Roberto-Barnhardt/CafeteraIOT/Memoria/Figures/hc-sr04.jpg

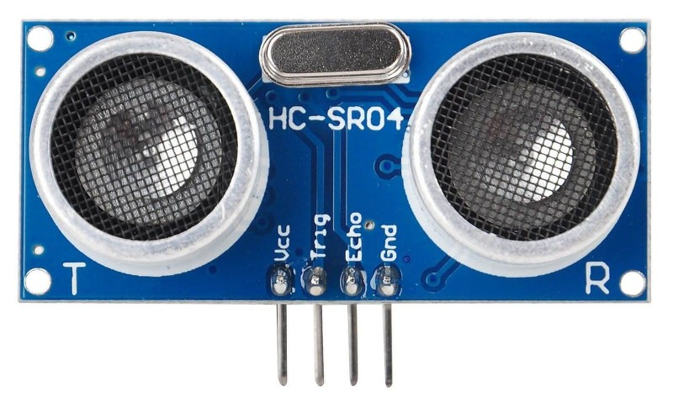
Memoria/Figures/hc-sr04.jpg
