Roberto-Barnhardt/CafeteraIOT/Memoria/Figures/microsw_cerrado.jpg

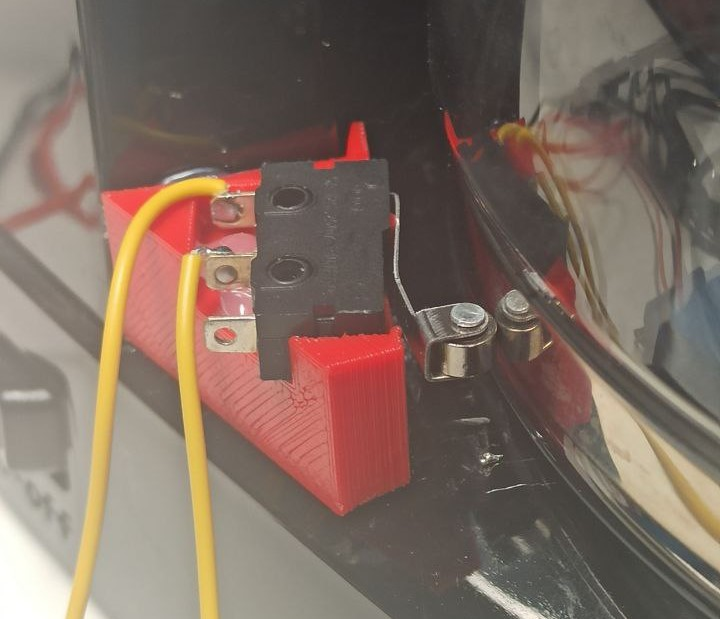
Memoria/Figures/microsw_cerrado.jpg
