Roberto-Barnhardt/CafeteraIOT/README.md

# Cafetera IOT

En este proyecto se van a integrar funcionalidades IOT en una cafetera convencional de filtro.
Diagrama
