Roberto-Barnhardt/CafeteraIOT/Art/Portada.png

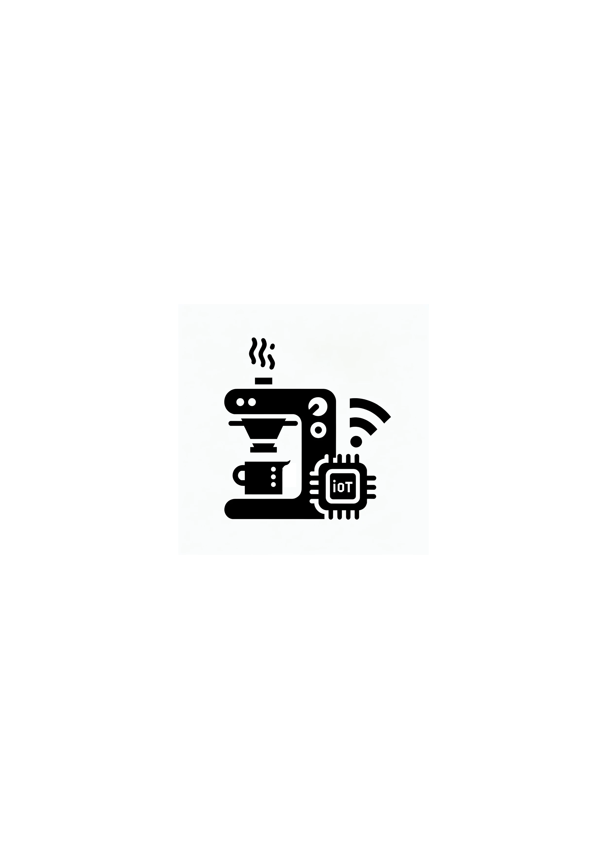
Art/Portada.png
