Roberto-Barnhardt/CafeteraIOT/CAD/GrabCAD/Exploded.png

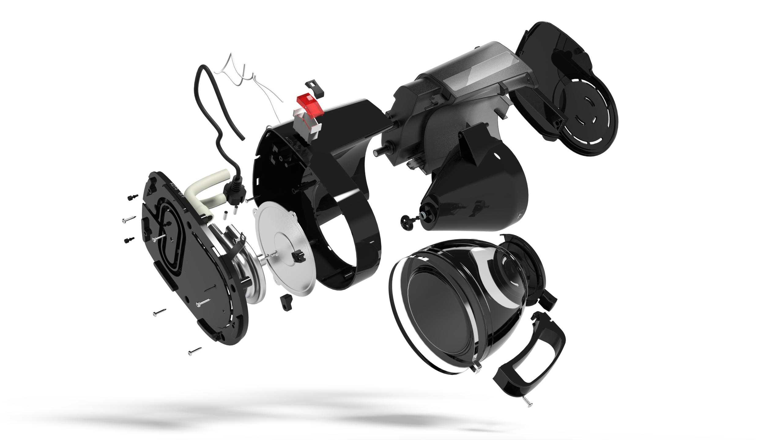
CAD/GrabCAD/Exploded.png
