Roberto-Barnhardt/CafeteraIOT/CAD/GrabCAD/Iso_1.png

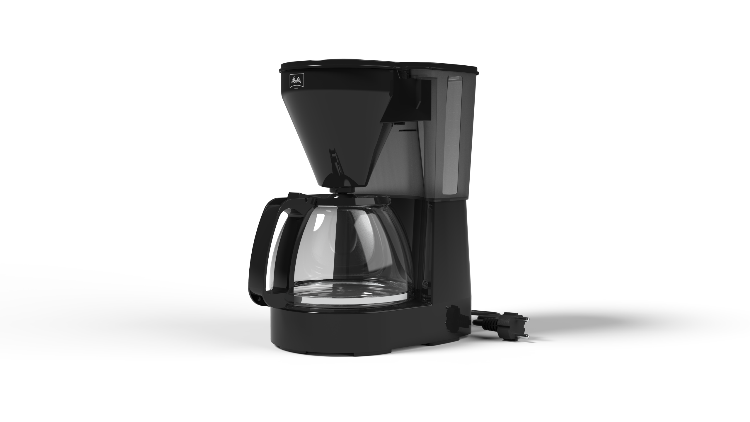
CAD/GrabCAD/Iso_1.png
