Roberto-Barnhardt/CafeteraIOT/CAD/GrabCAD/Iso_2.png

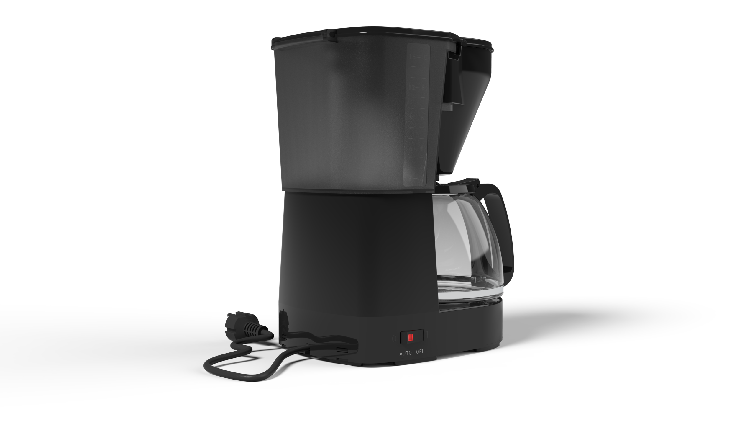
CAD/GrabCAD/Iso_2.png
