Roberto-Barnhardt/CafeteraIOT/CAD/GrabCAD/Iso_3.png

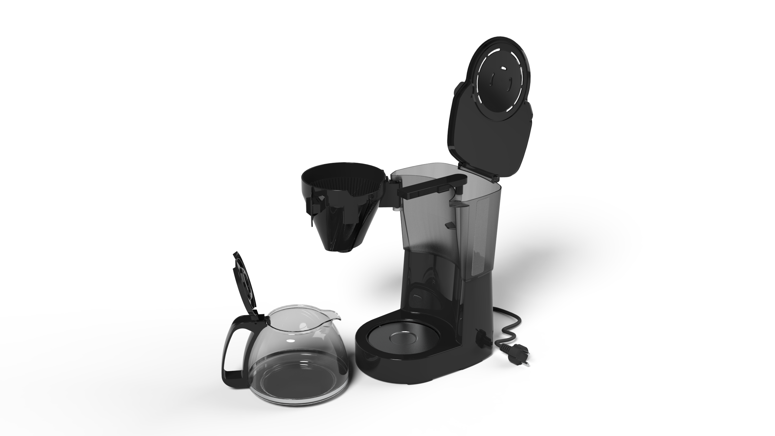
CAD/GrabCAD/Iso_3.png
