Roberto-Barnhardt/CafeteraIOT/CAD/GrabCAD/Iso_4.png

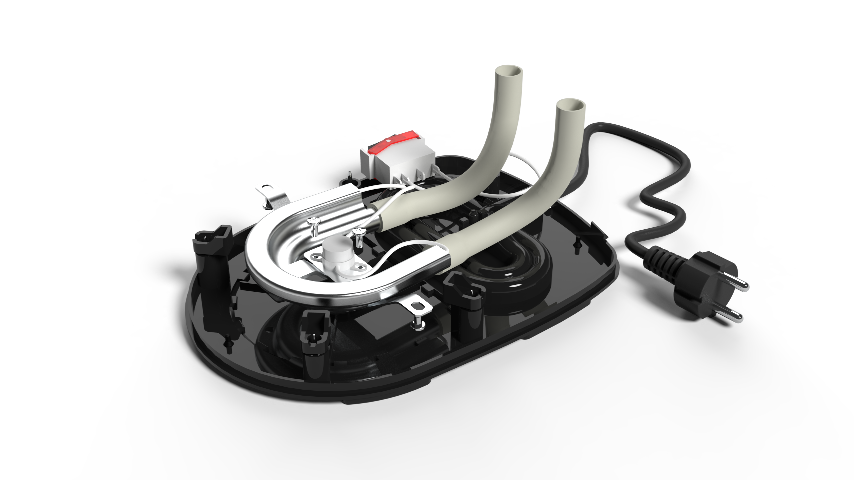
CAD/GrabCAD/Iso_4.png
