Roberto-Barnhardt/CafeteraIOT/Diagrama.png

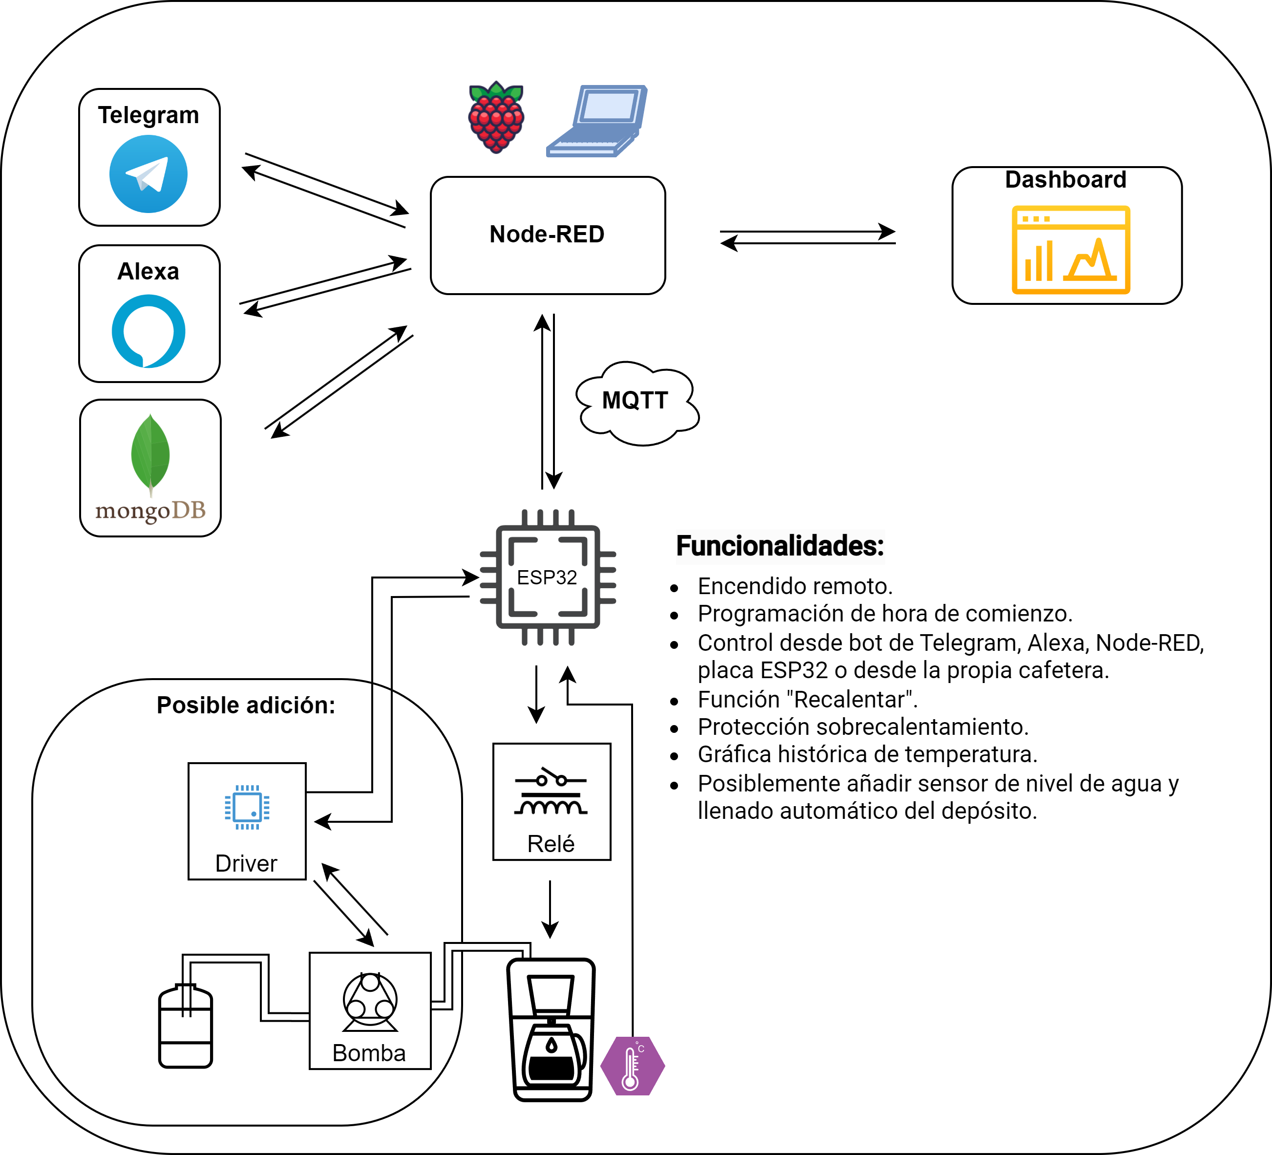
Diagrama.png
