Roberto-Barnhardt/CafeteraIOT/Memoria/Figures/Cafetera_antes.jpg

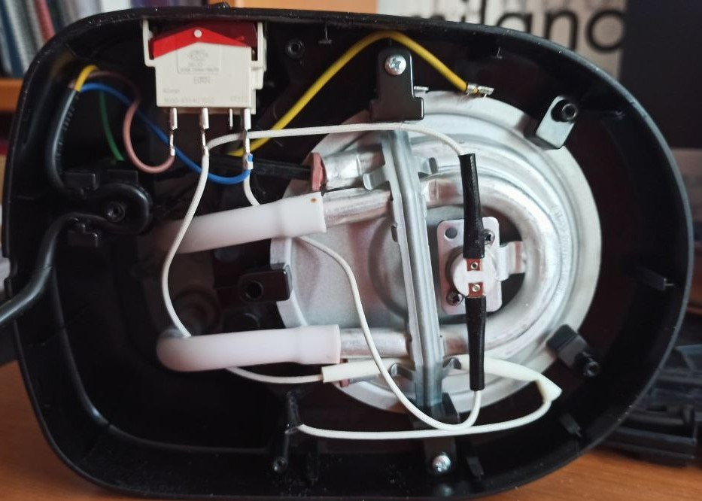
Memoria/Figures/Cafetera_antes.jpg
