Roberto-Barnhardt/CafeteraIOT/Memoria/Figures/Cafetera_despues.jpg

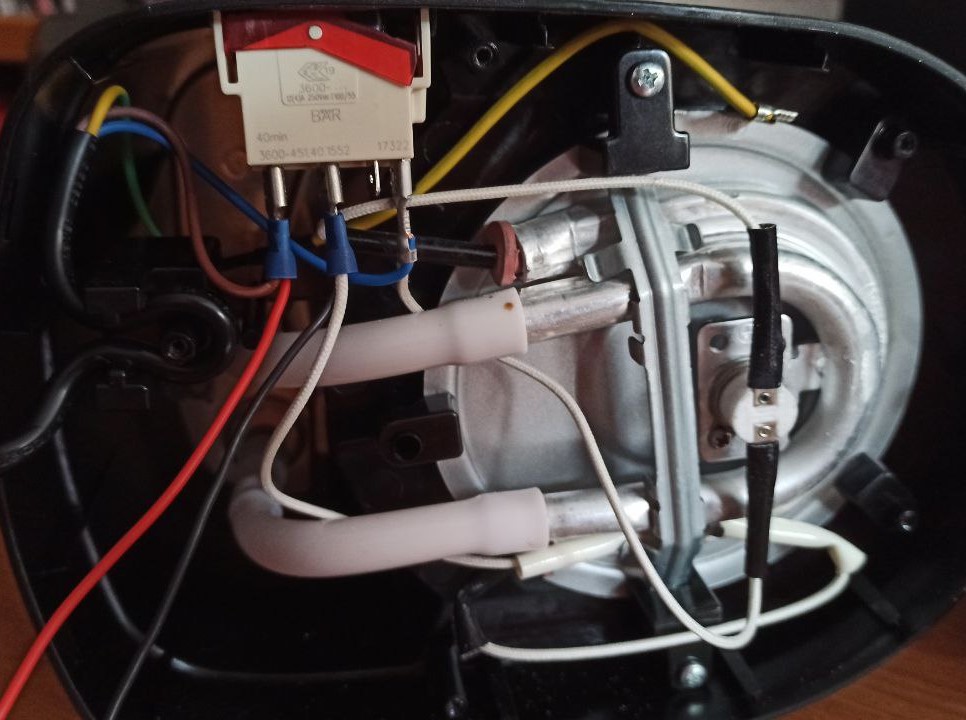
Memoria/Figures/Cafetera_despues.jpg
