Roberto-Barnhardt/CafeteraIOT/Memoria/Figures/Circuit_base.png

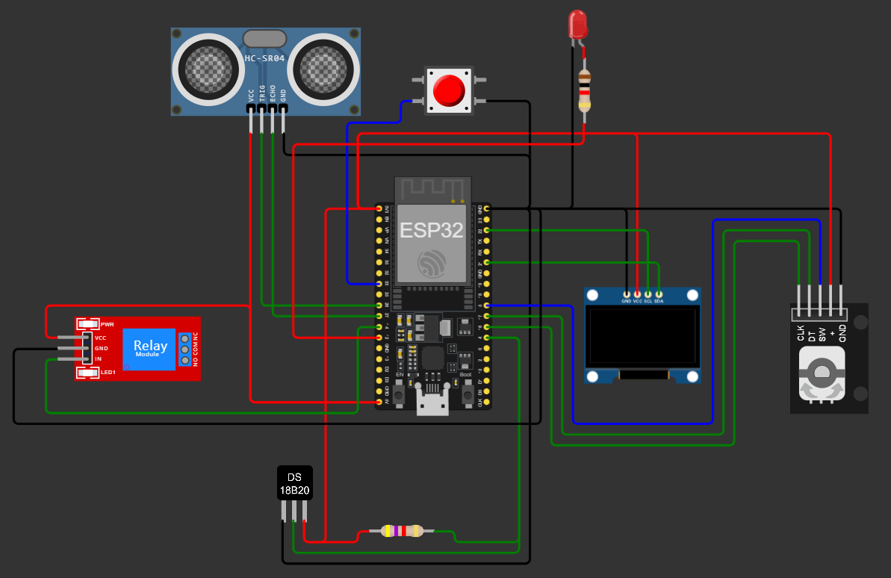
Memoria/Figures/Circuit_base.png
