Roberto-Barnhardt/CafeteraIOT/Memoria/Figures/Circuito.png

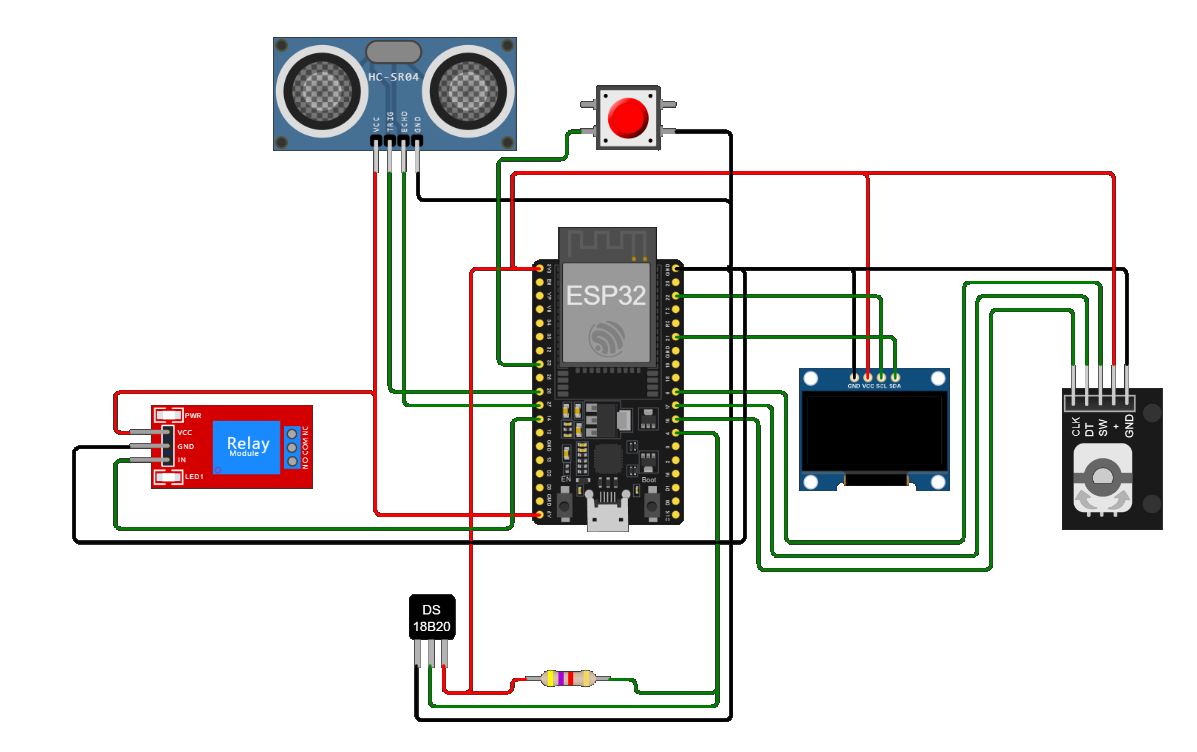
Memoria/Figures/Circuito.png
