Roberto-Barnhardt/CafeteraIOT/Memoria/Figures/MenuReal.jpg

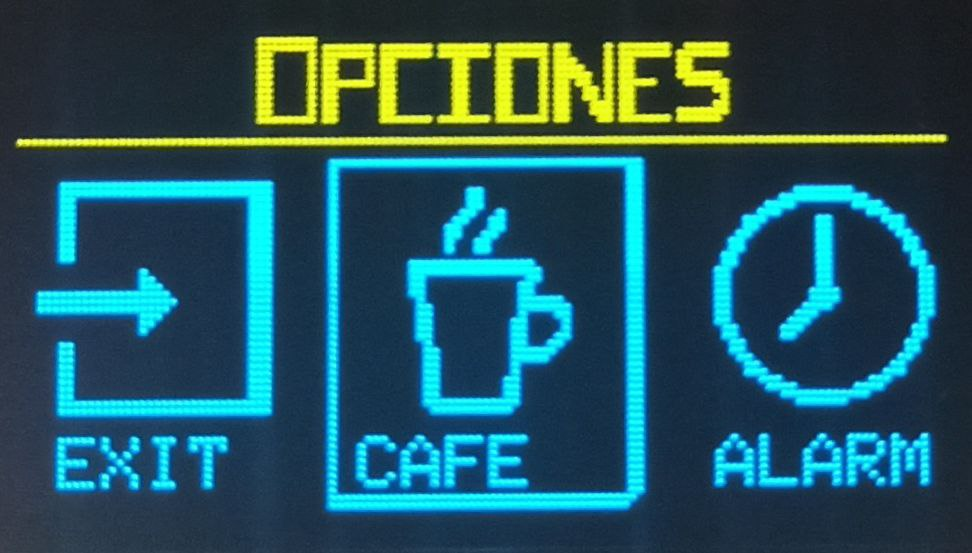
Memoria/Figures/MenuReal.jpg
