Roberto-Barnhardt/CafeteraIOT/Memoria/Figures/Microswitch.jpg

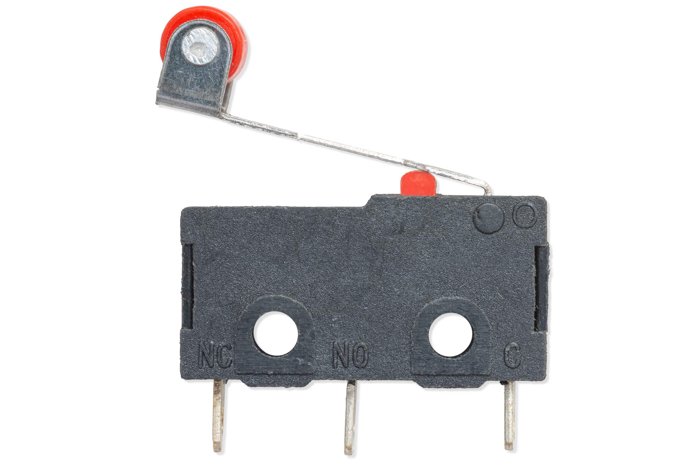
Memoria/Figures/Microswitch.jpg
