Roberto-Barnhardt/CafeteraIOT/Memoria/Figures/Portada.png

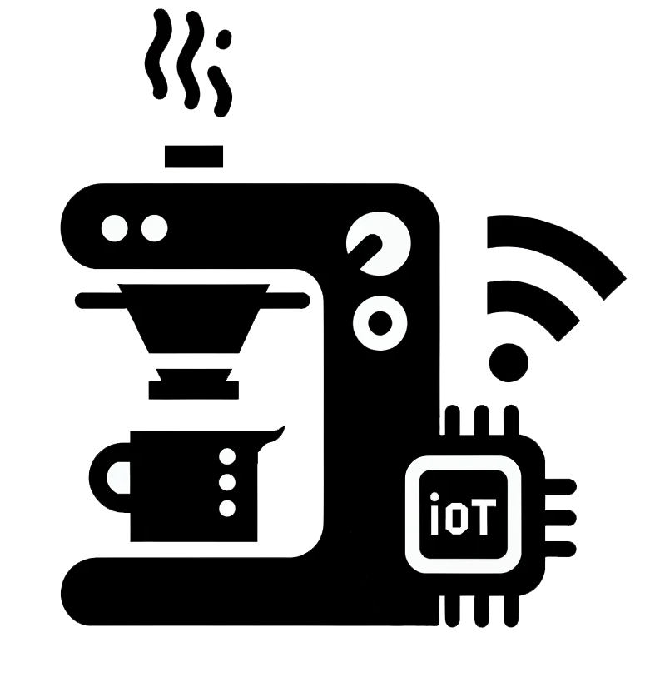
Memoria/Figures/Portada.png
