Roberto-Barnhardt/CafeteraIOT/Memoria/Figures/Tgramchat.png

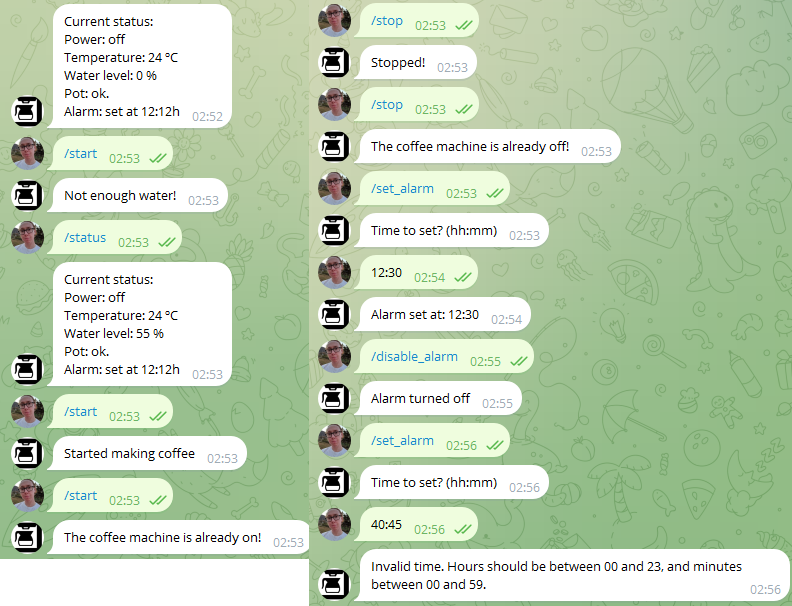
Memoria/Figures/Tgramchat.png
