Roberto-Barnhardt/CafeteraIOT/Memoria/Figures/Timeoutflow.png

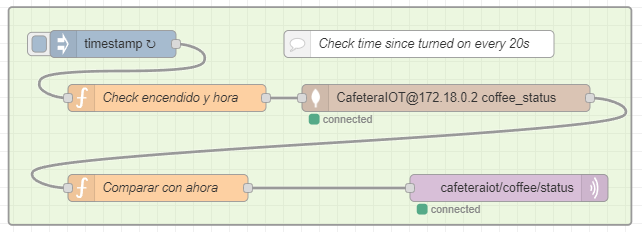
Memoria/Figures/Timeoutflow.png
