Roberto-Barnhardt/CafeteraIOT/CAD/microswitch 10T85.sldprt

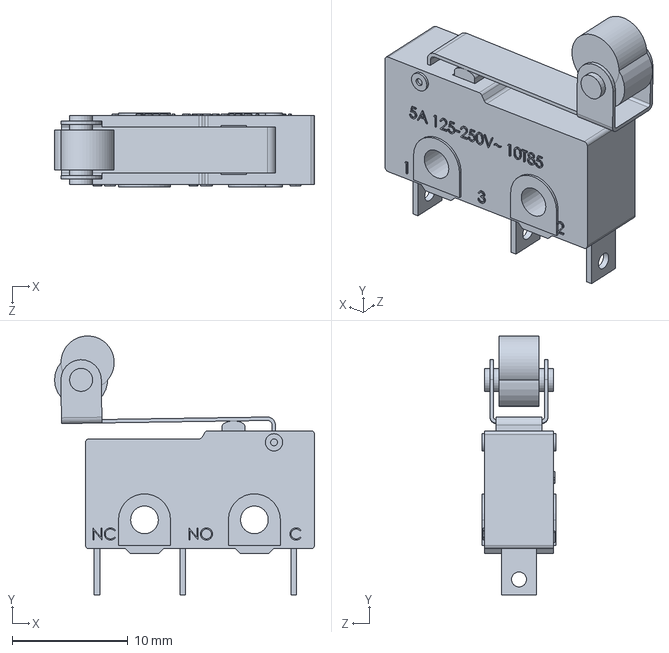
[picture p41: CAD file, 2024-01-01]
CAD/microswitch 10T85.sldprt
22.5 x 22.4 x 6.40 mm
