Roberto-Barnhardt/CafeteraIOT/CAD/2 Relay Module v2.step

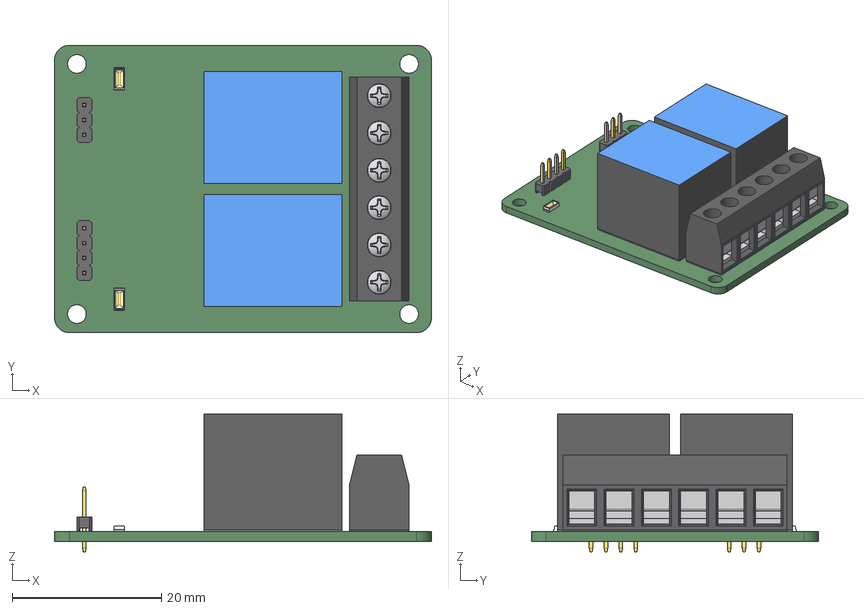
[picture p42: CAD file, 2024-01-01]
CAD/2 Relay Module v2.step
50.5 x 38.5 x 18.5 mm
pin header 1x3 pitch 2mm heigth 5mm
pin header 1x4 pitch 2mm heigth 5mm
LED IN1
LED IN2
Screw x 6
