Roberto-Barnhardt/CafeteraIOT/CAD/ss-5gl2.stp

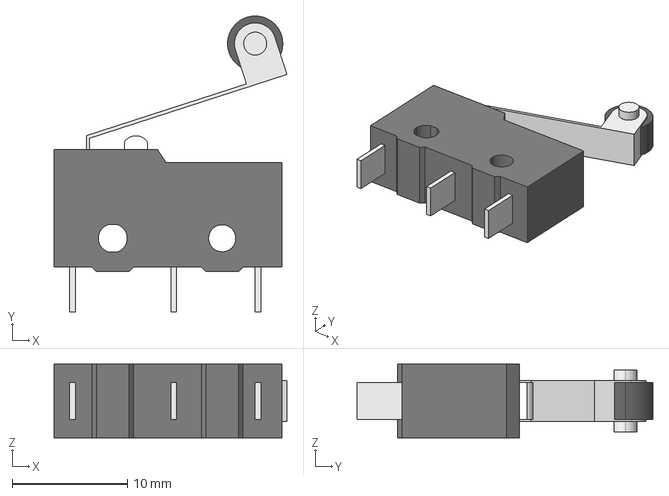
[picture p43: CAD file, 2024-01-01]
CAD/ss-5gl2.stp
20.2 x 25.7 x 6.40 mm
