Roberto-Barnhardt/CafeteraIOT/CAD/switchHolder.stl

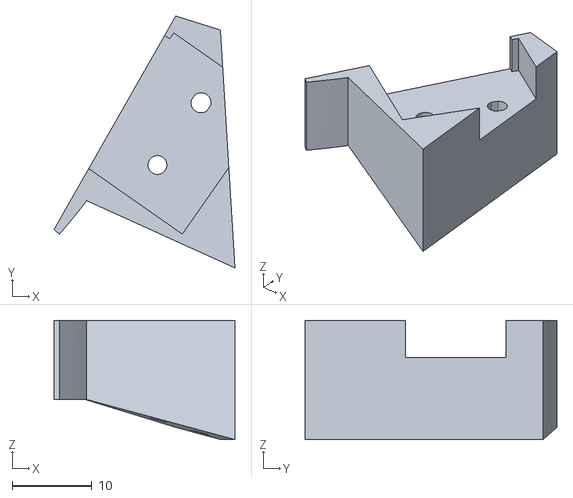
[picture p44: CAD file, 2024-01-01]
CAD/switchHolder.stl
22.6 x 31.5 x 14.9
