Roberto-Barnhardt/CafeteraIOT/(list of files, cad)

Other CAD files:
CAD/microswitch-msw-13-17-1.snapshot.6/MSW-13-17.iam
CAD/microswitch-msw-13-17-1.snapshot.6/MSW-13-17_body#.ipt
CAD/microswitch-msw-13-17-1.snapshot.6/MSW-13-17_button#.ipt
CAD/microswitch-msw-13-17-1.snapshot.6/MSW-13-17_lever#.ipt
