Roberto-Barnhardt/CafeteraIOT/(commit log)

2023-12-27 alarm setting is broken but getting there
    [CafeteraIOT.ino]
2023-12-28 Fixed button debounce
2024-01-01 Alarma funcionando, control de rele, sensor temperatura y ultrasonico
    [2 Relay Module v2.step, MSW-13-17.iam, MSW-13-17_body#.ipt, MSW-13-17_button#.ipt, MSW-13-17_lever#.ipt, microswitch 10T85.sldprt, ss-5gl2.stp, switchHolder.stl]
2024-01-04 Added Node-RED flow, still WIP
2024-01-04 Updated Node-RED flow, Atlas MongoDB working, arquitechture changed slightly
